hodat008/Amplifier-circuit/Actual results.png

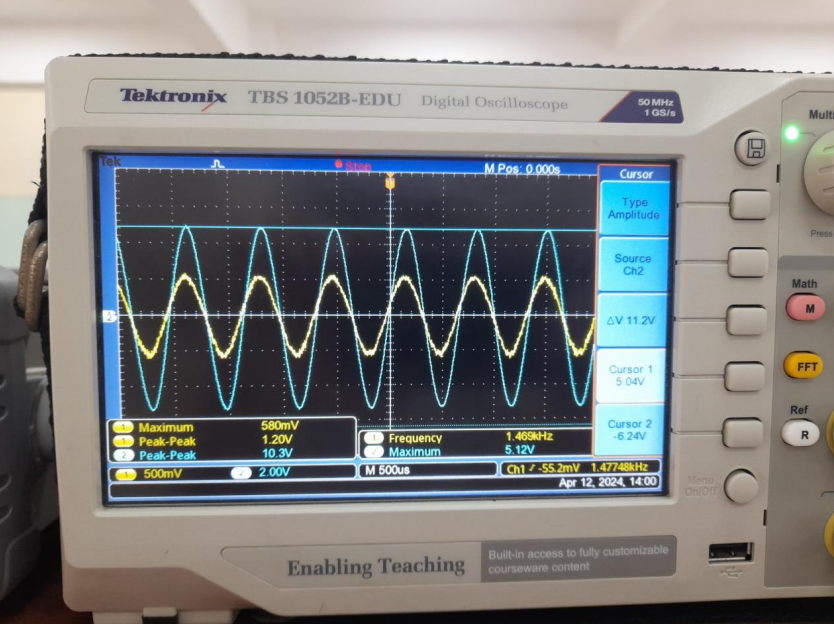
Actual results.png
