hodat008/Amplifier-circuit/README.md

# Amplifier-circuit
Design, construct and simulate amplifier circuit, meeting the following requirements:
- Input impedance: > 100K
- Output impedance: < 1K
- Input source impedance 1K, max amplitude 1Vpp
- Voltage gain: 10
- Bandwidth: 15Hz - 15KHz
