hodat008/Amplifier-circuit/Full report.pdf

I. CƠ SỞ LÝ THUYẾT

### 1.1. Cấu tạo của BJT

Transistor lưỡng cực (hay BJT - Bipolar Junction Transistor) là linh kiện bán dẫn

có cấu tạo cơ bản dựa trên 2 chuyển tiếp P-N. Linh kiện 3 điện cực này được sử dụng

như một phần tử khuếch đại hoặc như một khóa điện tử. BJT là khối đơn vị cơ bản xây

dựng nên cấu trúc mạch ở máy tính điện tử và tất cả các thiết bị điện tử hiện đại khác.

Transistor là một linh kiện bán dẫn 3 lớp, bao gồm 2 lớp bán dẫn loại N và một

lớp bán dẫn loại P (gọi là Transistor NPN) hoặc gồm 2 lớp bán dẫn loại P và một lớp

bán dẫn loại N (gọi là Transistor PNP).

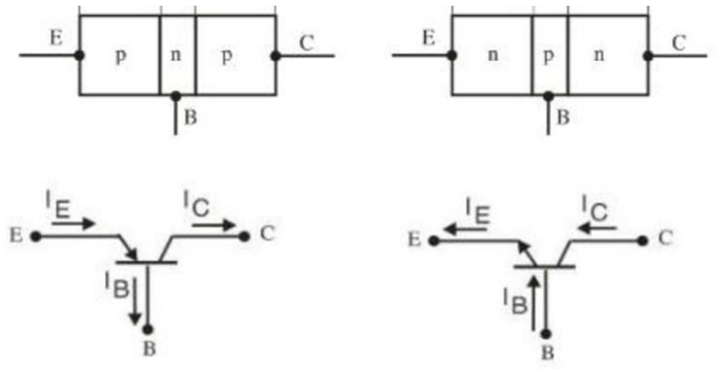
[picture p2: figure]

Cấu trúc và kí hiệu transistor PNP và NPN

Các cực được kí hiệu bằng các kí tự E (Emitter – cực phát), C (Collector – cực

thu) và B (Base – cực nền).

### 1.2. Nguyên lý hoạt động của BJT

Nguyên lý hoạt động của BJT (Bipolar Junction Transistor) dựa trên việc điều

khiển dòng điện qua các lớp bán dẫn của transistor bằng một dòng dẫn điện nhỏ hơn.

BJT là loại transistor ba khối, gồm ba lớp bán dẫn là base, emitter và collector. Trong

BJT, dòng điện chạy từ emitter tới collector và được điều khiển bởi một dòng dẫn điện

điều khiển vào base.

Ở transistor NPN, khi dòng điện dương được đưa vào base, nó sẽ kích hoạt và

tăng cường dòng điện dương chạy từ emitter tới collector. Phần lớn các hạt tải điện trong

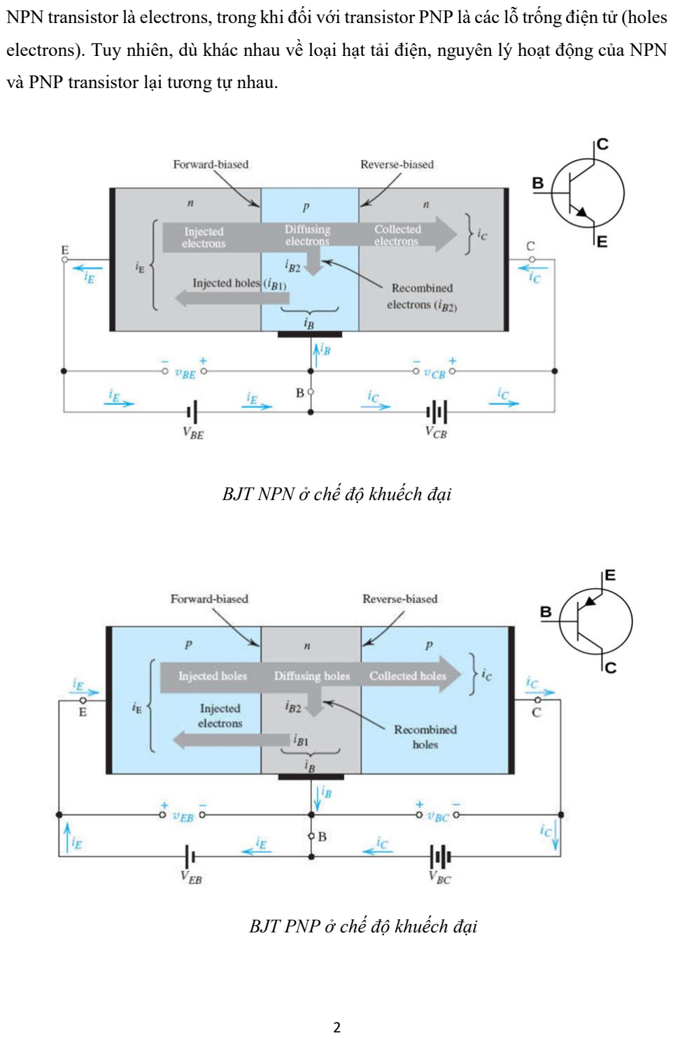
[picture p3: page 2]

NPN transistor là electrons, trong khi đối với transistor PNP là các lỗ trống điện tử (holes

electrons). Tuy nhiên, dù khác nhau về loại hạt tải điện, nguyên lý hoạt động của NPN

và PNP transistor lại tương tự nhau.

BJT NPN ở chế độ khuếch đại

BJT PNP ở chế độ khuếch đại

Trong BJT, số lượng điện tử cơ bản chịu trách nhiệm chỉ chiếm một phần nhỏ

trong tổng số dòng điện chạy qua (đa số), phần lớn dòng điện được tạo ra bởi các điện

tử không cơ bản (thiểu số). Khi một dòng dẫn điện vào base của transistor, điện trường

được tạo ra giữa hai điốt, base và emitter (hoặc collector), và điện trường này sẽ điều

khiển dòng điện chạy giữa hai diode. Do đó, BJT có thể được sử dụng để tạo ra các kết

nối ampli, chuyển đổi tín hiệu, và như một công tắc trong các mạch điện tử.

Transistor NPN là một loại transistor gồm ba lớp bán dẫn, bao gồm hai lớp N

(âm) được phân cách bởi một lớp P (dương). Chế độ hoạt động của transistor NPN bao

gồm ba trạng thái chính: cắt, bão hòa và dẫn.

Trạng thái cắt: không có dòng điện chạy qua transistor vì hai điện cực của nó

không được kết nối với nhau. Trong trạng thái này, transistor hoạt động như một vật cản

cho dòng điện.

Trạng thái bão hòa: một điện áp được áp dụng giữa đầu vào (điện cực cực âm)

và đầu ra (điện cực cực dương) của transistor, tạo ra một dòng điện cơ bản trong

transistor. Trong trạng thái này, transistor hoạt động như một bộ khuếch đại dòng.

Trạng thái dẫn: một điện áp đủ lớn được áp dụng giữa đầu vào và đầu ra của

transistor, tạo ra một dòng điện lớn trong transistor. Trong trạng thái này, transistor hoạt động như một công tắc hoặc bộ khuếch đại dòng lớn.

Trong một mạch điện, transistor NPN thường được sử dụng để khuếch đại hoặc

chuyển đổi tín hiệu điện. Chế độ hoạt động của transistor NPN là rất quan trọng trong

việc thiết kế các mạch điện tử.

### 1.3. Đặc tính của BJT

Khuếch đại dòng: BJT có thể được sử dụng để khuếch đại dòng, tức là đầu ra

lớn hơn đầu vào. Điều này là do điện áp và dòng điện được kiểm soát bởi dòng cơ bản

được điều khiển bởi dòng điều khiển.

Điều khiển dòng bằng điện áp: BJT có thể được điều khiển bằng một điện áp

nhỏ tại cổng điều khiển, dẫn đến sự điều khiển dòng điện lớn hơn tại đầu ra.

Tính chất tương tự: BJT có thể được sử dụng để kết nối hai mạch điện có điện

áp khác nhau với nhau, trong đó một mạch làm nguồn cấp điện và một mạch là đầu ra.

Điều này là do BJT có tính chất tương tự giống như tranzitor FET (Field Effect

Transistor).

Độ ổn định nhiệt độ tốt: BJT có thể giữ độ ổn định tốt ở nhiệt độ cao, điều này

giúp BJT có thể được sử dụng trong các mạch điện tử yêu cầu ổn định nhiệt độ.

### 1.4. Ứng dụng của BJT

Có 2 loại ứng dụng của BJT là: công tắc và khuếch đại

- BJT làm công tắc:

Đối với các ứng dụng làm công tắc, transistor được phân cực để hoạt động trong

vùng bão hòa hoặc vùng cắt (cutoff). Transistor trong vùng cắt sẽ hoạt động như một

công tắc mở trong khi ở trạng thái bão hòa sẽ hoạt động như một công tắc đóng.

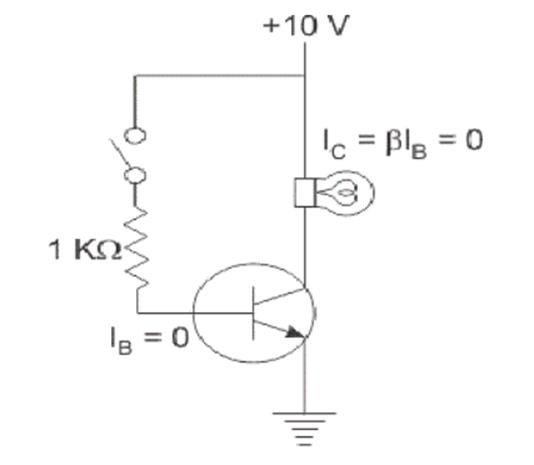
[picture p4: figure]

Công tắc mở

Trong vùng cắt (cả hai điểm nối đều bị phân cực ngược) điện áp qua điểm nối CE

rất cao. Điện áp đầu vào bằng 0 nên cả dòng điện cực gốc và dòng điện cực góp đều

bằng 0, do đó điện trở được cung cấp bởi BJT rất cao (lý tưởng là vô hạn).

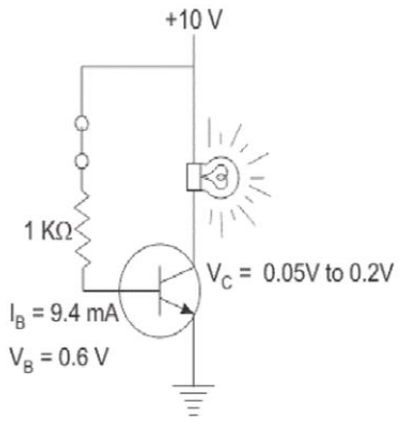
[picture p5: figure]

Công tắc đóng

Ở trạng thái bão hòa (cả hai điểm nối đều được phân cực thuận) một điện áp đầu

vào cao được được đặt vào cực gốc. Giá trị của điện trở cực gốc được điều chỉnh sao

cho dòng điện cực gốc lớn chạy qua. Có một điện áp rơi nhỏ qua đường giao nhau của

cực góp cực phát từ 0,05 đến 0,2 V và dòng điện cực góp rất lớn. Một sự sụt giảm điện

áp rất nhỏ diễn ra trên BJT và tương đương với một công tắc đóng.

- BJT làm bộ khuếch đại:

Hình dưới là một bộ khuếch đại CE một tầng. C1 và C3 là các tụ điện ghép nối

(coupling), chúng được sử dụng để chặn thành phần DC và chỉ cho phần xoay chiều đi

qua. Chúng cũng đảm bảo các điều kiện phân cực DC của BJT không thay đổi ngay cả

khi đầu vào được đặt. C2 là tụ điện bypass làm tăng độ lợi điện áp và bỏ qua điện trở R4

cho tín hiệu AC.

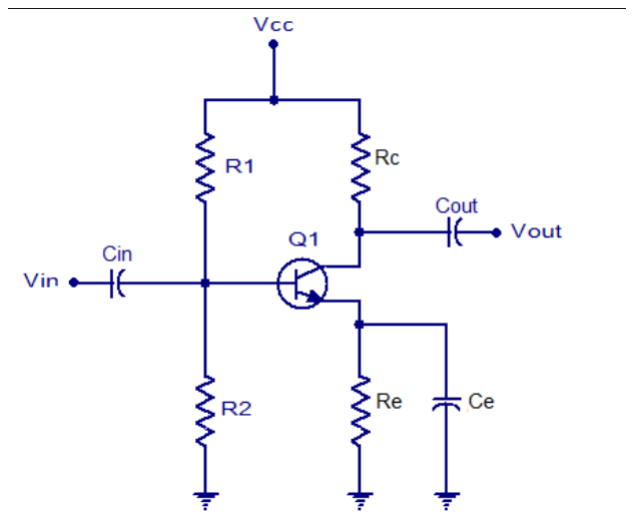
[picture p6: figure]

BJT được phân cực trong vùng hoạt động bằng cách sử dụng các thành phần phân

cực cần thiết. Điểm Q được tạo ra ổn định trong vùng hoạt động của transistor. Khi đầu

vào được đặt như hình dưới đây, dòng điện cực gốc bắt đầu thay đổi lên và xuống, do

đó dòng điện cực góp cũng thay đổi khi IC = β × IB. Do đó điện áp trên R3 thay đổi khi

dòng điện cực góp đi qua nó. Điện áp trên R3 là điện áp được khuếch đại và cách nhau

180o

so với tín hiệu đầu vào. Do đó điện áp trên R3 được ghép nối với tải và quá trình

khuếch đại diễn ra. Nếu điểm Q được duy trì ở tâm tải thì sẽ có rất ít hoặc không xảy ra

hiện tượng méo dạng sóng. Điện áp cũng như độ lợi dòng điện của bộ khuếch đại CE

cao (độ lợi là hệ số mà điện áp của dòng điện tăng từ đầu vào đến đầu ra). Nó thường

được sử dụng trong radio và làm bộ khuếch đại điện áp tần số thấp.

### 1.5. Các mạch khuếch đại cơ bản thường gặp

Mạch khuếch đại là mạch điện tử trong đó với một sự biến đổi nhỏ của đại lượng

điện ở đầu vào sẽ gây ra sự biến đổi lớn của đại lượng điện ở đầu ra. Các phần tử cơ bản

của mạch điện là BJT hay FET,... Dùng BJT để làm mạch khuếch đại, khi đó ta cần thiết

kế sao cho BJT hoạt động ở chế độ active mode (tức là điểm làm việc tĩnh nằm ở vùng

active).

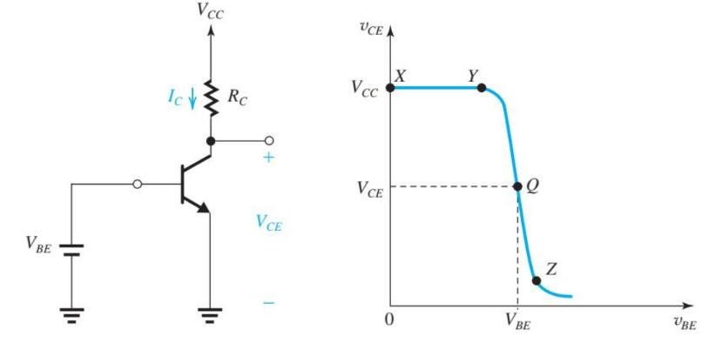
[picture p7: figure]

* Các mạch khuếch đại cơ bản:

a. Mạch khuếch đại ghép E chung (Common Emitter - CE)

Mạch khi xét ở chế độ AC có dạng:

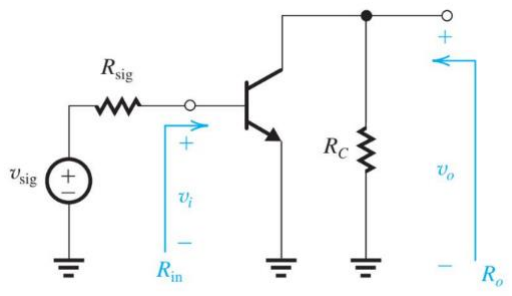
[picture p8: figure]

Mạch tương đương tín hiệu nhỏ:

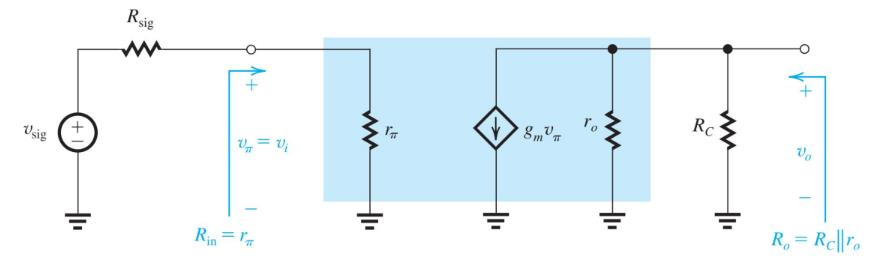
[picture p9: figure]

Rin = rπ; Ro = RC//ro ≈ RC

AV =

vo
vi

= −gm(RC//ro) ≈ −gmRC; GV =

vo

vsig

= −

rπ

rπ+Rsig

gm(RC//ro)

- Đặc điểm thường có của mạch:

+ Tổng trở vào (Ri) khoảng vài KΩ

+ Tổng trở ra (Ro) từ vài chục KΩ đến vài trăm KΩ

+ Hệ số khuếch đại dòng điện (Ai): lớn từ vài chục đến hàng trăm lần

+ Hệ số khuếch đại điện áp (AV): lớn cỡ hàng trăm lần

+ Điện áp ra (Vo) ngược pha so với điện áp vào (Vi)

+ Dải thông của mạch hẹp b. Mạch khuếch đại ghép B chung (Common Base - CB)

Mạch khi xét ở chế độ AC có dạng:

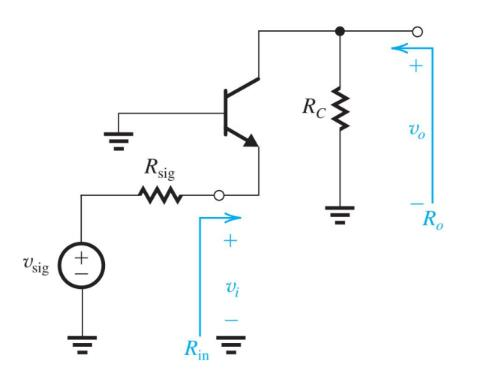
[picture p10: figure]

Mạch tương đương tín hiệu nhỏ:

Rin = re

; Ro ≈ RC

AV =

vo
vi

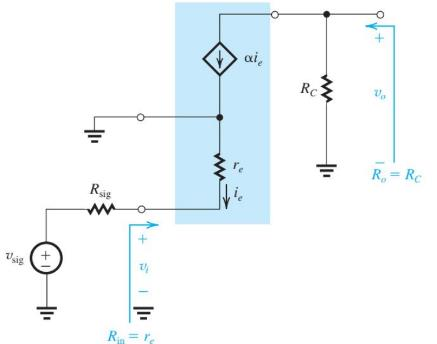
[picture p11: figure]

= gmRC; GV =

vo

vsig

=

re

re+Rsig

gmRC

- Đặc điểm thường có của mạch:

+ Tổng trở vào (Ri) khoảng vài chục Ω

+ Tổng trở ra (Ro) vài trăm KΩ

+ Hệ số khuếch đại dòng điện (Ai): nhỏ, xấp xỉ 1

+ Hệ số khuếch đại điện áp (AV): lớn cỡ hàng trăm lần

+ Điện áp ra (Vo) cùng pha so với điện áp vào (Vi)

+ Dải thông của mạch rộng c. Mạch khuếch đại ghép C chung (Common Colector – CC)

Mạch khi xét ở chế độ AC có dạng:

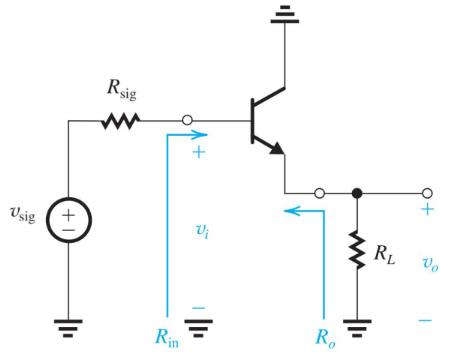
[picture p12: figure]

Mạch tương đương tín hiệu nhỏ (xem ro rất lớn -> bỏ qua):

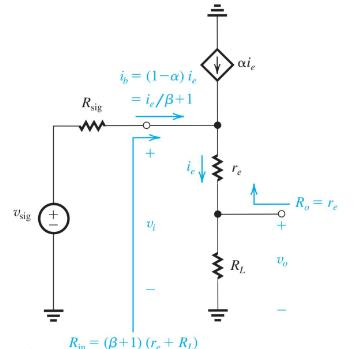
[picture p13: figure]

Rin = (β + 1)(re + RL

); Ro = re

AV =

vo
vi

=

RL
re+RL
- Đặc điểm thường có của mạch:

+ Tổng trở vào (Ri) khoảng vài KΩ

+ Tổng trở ra (Ro) khoảng vài chục Ω

+ Hệ số khuếch đại dòng điện (Ai): lớn, từ vài chục đến hàng trăm lần

+ Hệ số khuếch đại điện áp (AV): nhỏ, xấp xỉ 1

+ Điện áp ra (Vo) cùng pha so với điện áp vào (Vi)

+ Dải thông của mạch trung bình

II. | CƠ SỞ TÍNH TOÁN, BIỆN LUẬN CÁC GIÁ TRỊ, THÔNG SỐ CỦA
| MẠCH
| Để đáp ứng điện trở vào cao ( Ri >100k Ω), điện trở ngõ ra thấp (Rout ≤ 1kΩ) với
độ lợi AV = 10; và để đảm bảo tín hiệu ngõ ra cùng pha với tín hiệu ngõ vào (đảm bảo giữ được các tính chất cơ bản của tính hiệu đầu vào) => Ta sử dụng mạch khuếch đại Cascade CE-CE với các thông số trở của hai mạch khác nhau để đảm bảo các yêu cầu đặt ra của đề bài.
| Với yêu cầu đề là Rs = 1kΩ nhóm chọn giá trị R=1kΩ để thỏa mãn đề bài. Chọn
giá trị ngõ vào là 1V (Vp-p) để thuận tiện cho ngõ vào lớn nhất mà mạch có thể đáp ứng.
| Và dưới đây là dạng mạch mà nhóm em đã sử dụng để tiến hành thiết kế:

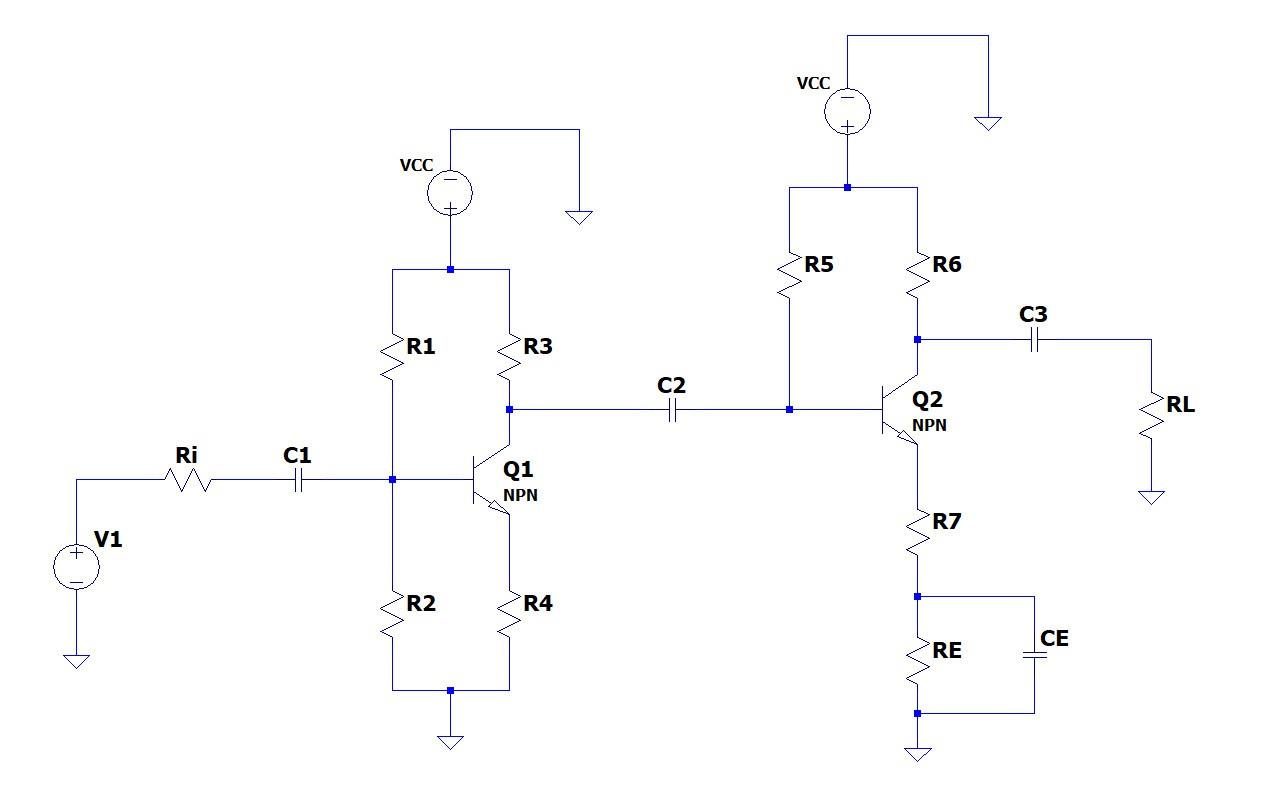
[picture p14: figure]

### 2.1. Chọn BJT để thiết kế mạch

Vì tính dễ hoạt động, dễ tìm và chi phí rẻ nên nhóm lựa chọn BJT 2N222 để thiết

kế mạch.

Datasheet:

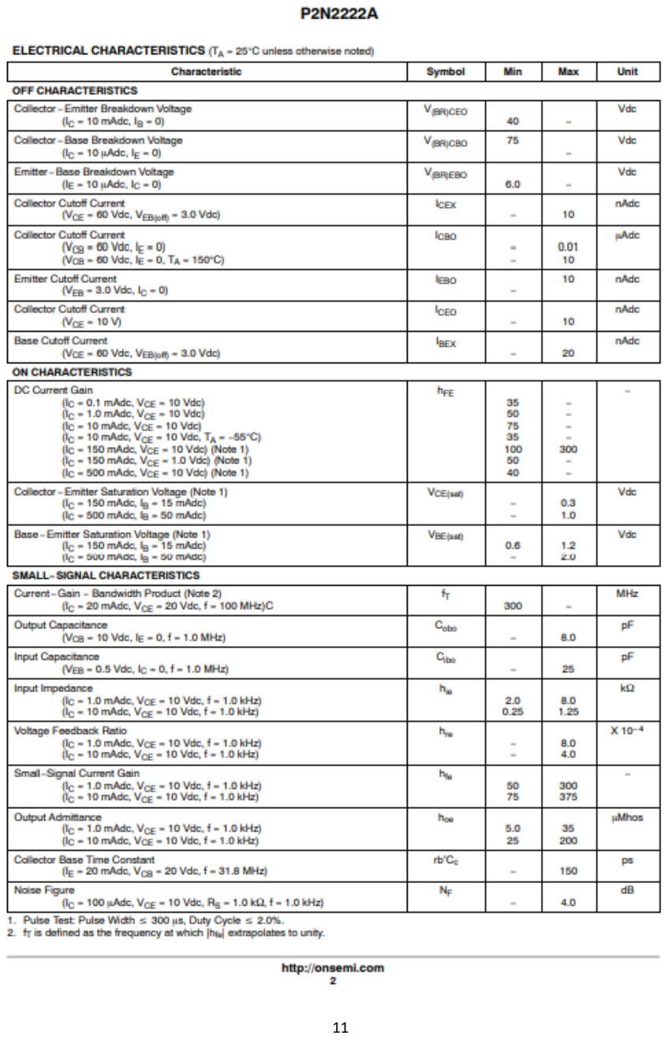
[picture p15: page 11]

### 2.2. Thiết kế tầng đệm:

Sau khi đã chọn BJT, chúng em sẽ tìm các thông số của điện trở cho tầng đệm:

Chọn điểm hoạt động của BJT 2N2222 thứ 1: Q (ICQ1, VCEQ1) = (2mA, 5V), β1 = 200

Chọn VCC = 18V, chọn VCEQ1 = 3.3kΩ, R2=330kΩ

Ta có:

Mặt khác:

1 | 1 3 | 4 .( | ) V | I | R | R | V CC | C | CE = | + | + 3

3

18 2.10 .( | 3,3 ) 5 R | k -
= | + | +
- R3 = 3.2k => Chọn R3 = 3.3kΩ

Và

1

1

1 2
4
1 | 1 | 2
3 | 3 | 3
1 | 3 | 3
3 | 3
1 | 1
. | . | | 0,7
330.10 | 2.10 | .330.10 18. | . | 2.10 .3,3.10 | 0,7
330.10 | 200 | 330.10

C
th | C
I | RR V | I R
R | R

R
R | R

β

= | + | +
+
Û | = | + | +
+ | +
| → R1 = 333kΩ. Chọn R1 = 330kΩ

Sau khi có các giá trị điện trở của phần mạch CE đầu tiên nhóm em tiến hành vẽ lại mạch trên mô phỏng proteus và cung cấp nguồn 18V DC để tính và kiểm chứng lại

giá trị của β1 và tính toán giá trị của

1

Rπ .

Mạch mô phỏng của đoạn mạch này ở chế độ DC là:

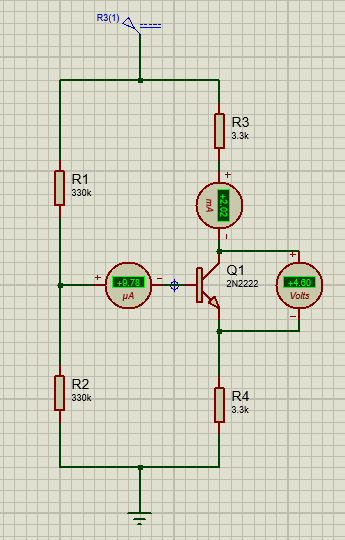
[picture p16: figure]

Từ các thông số của đồng hồ DC, nhóm em tính được:

β1 =

ICQ1

IB1

=

2mA
10μA

= 200

Từ đó tìm được giá trị:

rπ1 = β1 ×

VT

ICQ1

= 200 ×

25mV
2mA

= 2.5kΩ

Tiến hành tính toán lại giá trị Zin ta có giá trị:

Zin =

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
rπ1 + (β1 + 1) × R4

=

1
1
330k

+

1
330k

+

1
2.5k + (200 + 1) × 3.3k

= 132.23kΩ

- Thỏa mãn được yêu cầu của đề bài về phần Zin > 100kΩ

### 2.3. Tầng khuếch đại

Đối với đoạn mạch CE thứ 2: Đoạn mạch chính để đáp ứng độ lợi của toàn mạch.

Chọn điểm hoạt động của BJT 2N2222 thứ 2: Q (ICQ2,VCEQ2) = (9mA, 6V), β2 =

200

Với sơ đồ tương đương như hình dưới và đáp ứng yêu cầu Zout < 1kΩ, nhóm em tiến hành chọn giá trị cho RC2 = 990Ω để vừa đảm bảo giá trị ngõ ra thỏa mãn yêu cầu đề bài và độ lợi của toàn mạch đạt giá trị lớn khả quan.

Chọn VCC=18V, chọn R6 = 990Ω

Ta có:

2 | 6 | 7 | 2 .( | ) V | I | R | R | V CC | CQ | CEQ = | + | + 3

7

18 9.10 .(990 ) 6 R

= | + | +
- R7 = 350Ω
- Để đảm bảo độ lợi của toàn mạch là 10 thì giá trị của điện trở RE3 <

RC2
10

= 99Ω

Nhóm em lựa chọn giá trị của trở R7 = 66Ω; RE = 330Ω.

Và

2

2

5 | 7
2
. | . | 0,7 CQ
CC | | CQ

I
V | R | I | R
β
= | + | +

18 =

9 × 10⁻³
200

. R5 + 9 × 10⁻³
. 350 + 0.7

=>R5 = 305kΩ . Chọn R5 = 330kΩ

Sau khi có các giá trị điện trở của phần mạch CE thứ hai nhóm em tiến hành vẽ lại mạch trên mô phỏng proteus và cung cấp nguồn 18VDC để tính và kiểm chứng lại giá trị của β2 và tính toán giá trị của rπ2

Mạch mô phỏng của đoạn mạch này ở chế độ DC là:

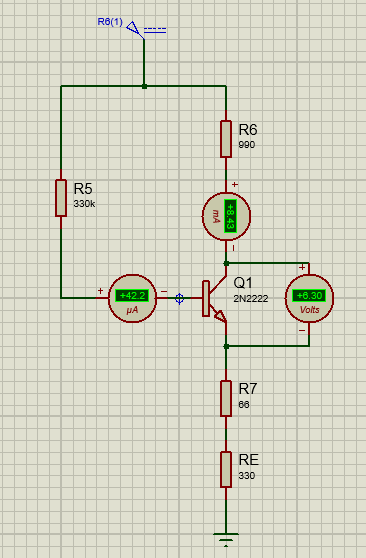
[picture p17: figure]

Từ các thông số của đồng hồ DC, nhóm em tính được:

β2 =

ICQ2
IB

=

8.43mA
42.2μA

= 200

Từ đó tìm được giá trị:

rπ2 = β2 ×

VT

ICQ2

= 200 ×

25mV
8.43mA

= 593Ω

- Khảo sát AC: Tín hiệu dãy giữa:

Sơ đồ tương đương AC:

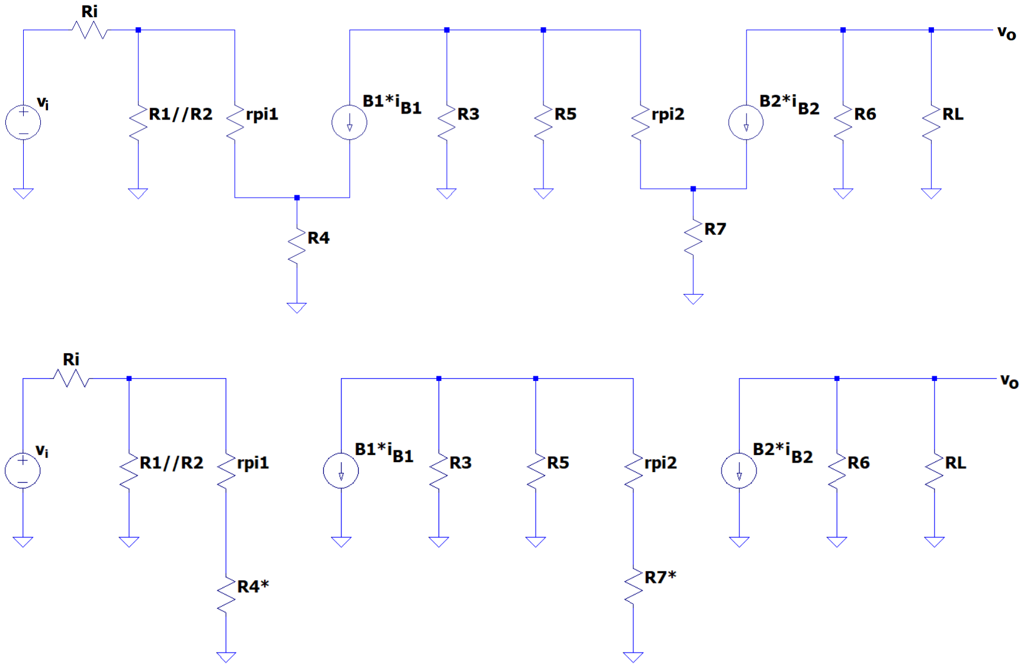
[picture p18: figure]

Ta có:

rπ1 = 2,5kΩ; R4 = (β1 + 1). R4 = 201.3,3kΩ = 663,3kΩ; R12 = R1||R2 = 165kΩ;
rπ2 = 556Ω; R7 = (β2 + 1). R7 = 201.66Ω = 13,3kΩ; R35 = R3||R5 = 3,3kΩ

### 2.4. Tín hiệu dãy giữa:

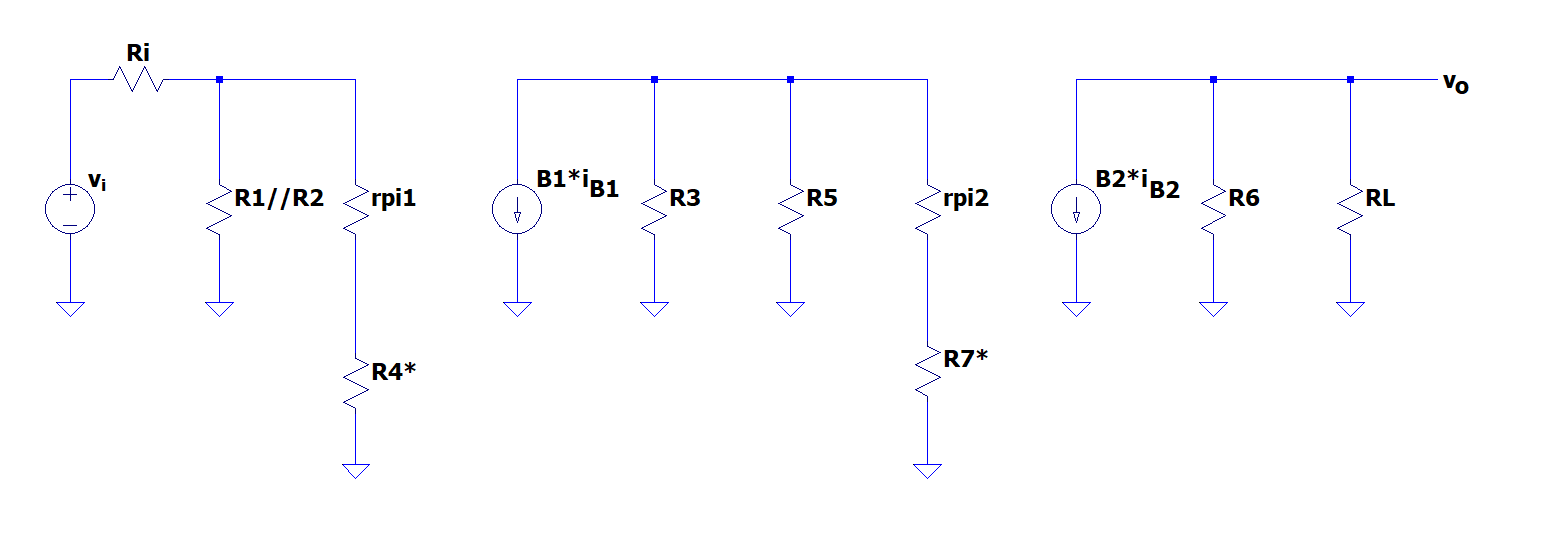
[picture p19: figure]

Ta có:

2 | 2 | 1 | 1
2 | 2 | 1 | 1
2 | 1
2 | 1
o | o | b | b | b | b
v
i | b | b | b | b | i
v | v | i | i | i i
A
v | i | i | i | i | v
| | β | | β
β | β
= | =

Trong đó:

Vo
β2ib2

= −(RL

∥ R6)

β2ib2

ib2

= β2

ib2
β1ib1

= −

(R3 ∥ R5)
rπ2 + R7

(β2 + 1) + (R3 ∥ R5)

β1ib1

ib1

= β1

ib1
Vi

= Ri

1
(R1 ∥ R2) + rπ1 + R4

(β1 + 1)
(R1 ∥ R2)

+ rπ1 + R4

(β1 + 1)

Suy ra:

Av = −RL

∥ R6 × β2 × (−

R3 ∥ R5
rπ2 + R7

∗ + R35

) × β1 ×

Ri
R12 + rπ1 + R4

∗
R12

+ rπ1 + R4

∗

Av = −(10k ∥ 990k) × 200 ×

3.3k
593 + 13.3k + 3.3k

× 200

×

1k
165k + 2.5k + 663.3k
165k

+ 2.5k + 663.3k

Mà Av= 10

Nên (RL
∥ R6

) = 0.9kΩ

Suy ra: RL = 9.9kΩ

Vậy ta chọn điện trở RL

trong thực tế có giá trị bằng 10 kΩ

### 2.5. Đáp ứng dải băng thông của mạch:

Sau khi đáp ứng độ lợi của mạch, nhóm em tiến hành mô phỏng trên phần mềm LT SPICE để xác định dải băng thông, tìm các thông số của các tụ để tần số cắt của mạch là 15Hz, và tần số cắt cao là 15KHz.

Với độ lợi là AV = 10 (V/V) thì ta tính được chỉ số dB là 20dB → Tần số cắt thấp và tần số cắt cao để xác định tần số là 20dB – 3dB = 17dB Sau khi tiến hành thay đổi giá trị của các tụ, nhóm em nhận thấy ở giá trị tụ được cho trong hình thì mạch đáp ứng được tần số cắt thấp và tần số cắt cao thỏa mãn được giá trị tối ưu (gần nhất so với 15KHz)

a. Tần số thấp:

Khảo sát DC: Tần số thấp:

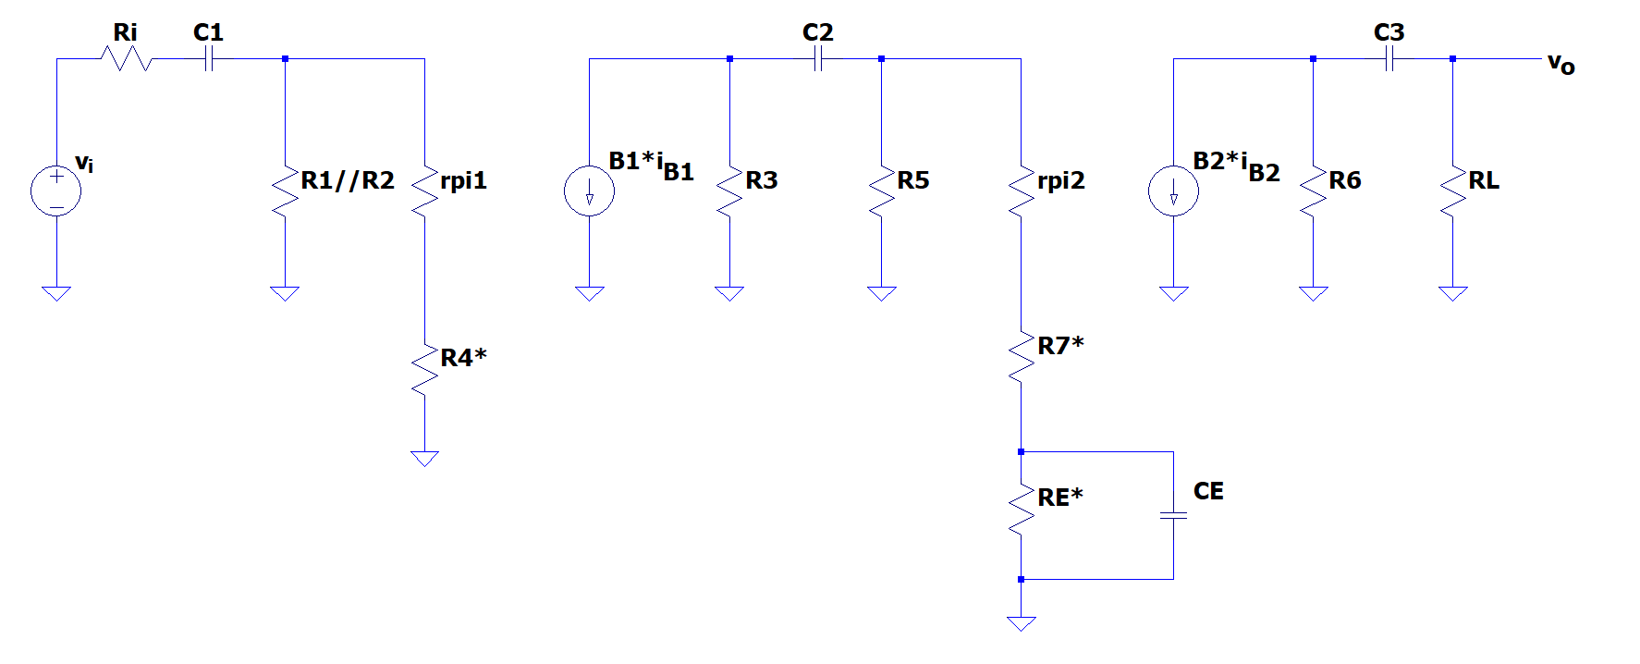
[picture p20: figure]

Tụ C1:

fL1 =

1

### 2π.[(R1 + R12)||(r

### π1 + R4)]C1

=

1

### 2π.[(1k + 165k)||(2,5k + 633,3k)]C1

=

1
837k.C1

Tụ C2:

fL2 =

1

### 2π.[(R3 + R5)||(r

### π2 + R7)]C2

=

1

### 2π.[(3,3k + 330k)||(556 + 13,3k)]C2

=

1
104,5k.C2

Tụ C3:

3
6 | 3 | 3 | 3
1 | 1 | 1
2 .( | ). | 2 .(990 10 ). | 69 . L
L

f
π | π R | R C | k C | k C
= | = | =
+ | +

Tụ CE:

fLCE =

1

### 2π.[RE||(R7 +

### rπ2 + R35

β2

)]CE

=

1
2π.[330||(66 +

556 + 3,3k
200 + 1

)CE

=

1
426.CE

Ta có

1 | 2 | 3 , | ,
C | C | C E | E | E L | L | L | L | L | L f | f f | f f | f >> | >> | >>

Nên

1
15
426. CE
L | L
E
f | f | Hz
C
= | = | ≥

Suy ra: Tụ CE ≤ 149,6µF

Chọn các tụ như sau:

- Tụ có nhiệm vụ ngăn cách hai mạch ở chế độ DC C2 và C3 mang giá trị là 100μF.
- Các tụ có nhiệm vụ ngắn mạch trở ở chế độ AC của chân E của mạch chứa BJT thứ 2 là CE mang giá trị 100μF.
- Tụ ngăn cách nguồn vào mạch C1 mang giá trị là 100μF.
b. Tần số cao

Khi BJT hoạt động ở tần số cao, xuất hiện 2 tụ ký sinh là CBE =25pF và CBC =

8pF. Ta có sơ đồ với các tụ ký sinh như sau:

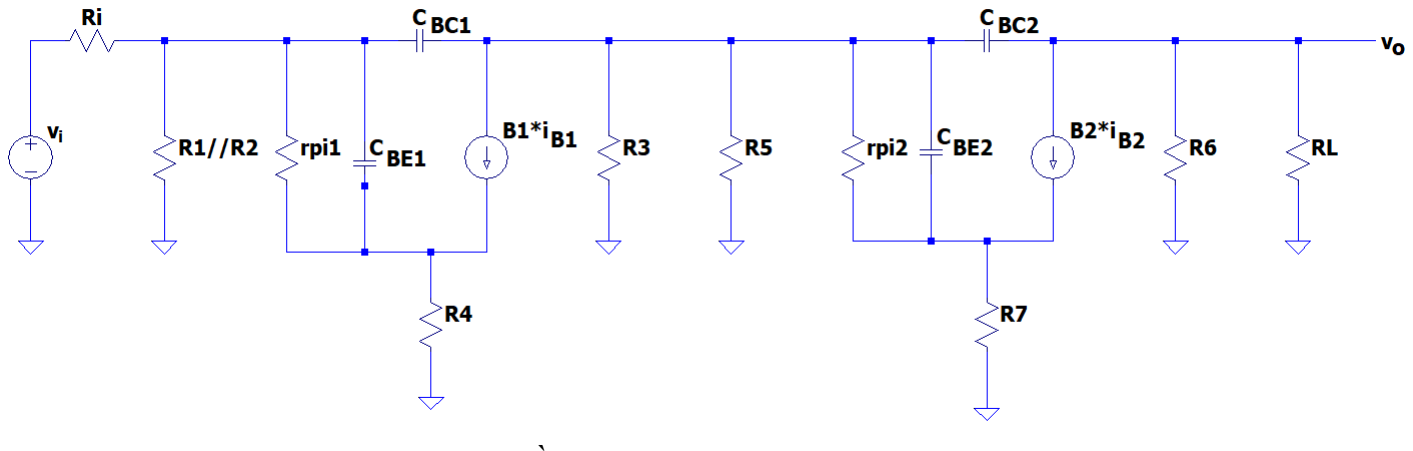
[picture p21: figure]

Xét các tụ ký sinh trên tầng đệm:

Ta có:

CEQ1 = CBC1.{1 + gm1.[R35||(rπ2 + R7

∗
)]} = 8pF.{1 + 0,08.[3,3k||(593 + 13,3k)]} = 1714pF Sơ đồ tương đương:

Tụ

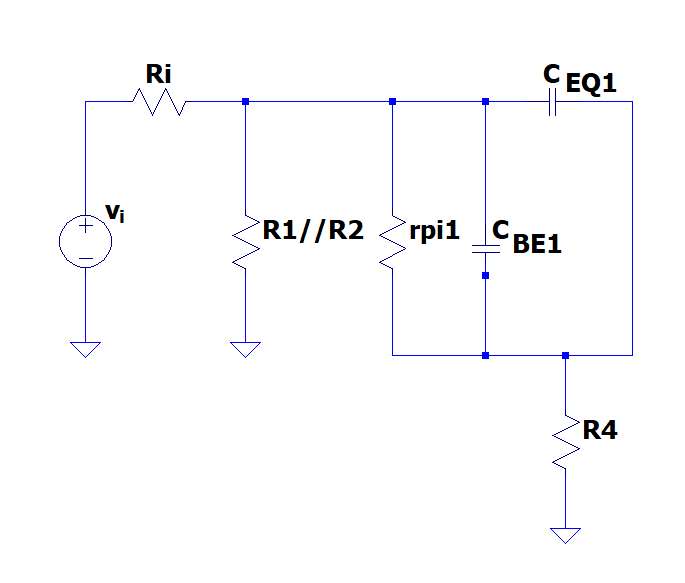
[picture p22: figure]

1 | 1 | 1 | 1714 25 1739 C | C | C | pF in | EQ | BE = | + | = | + | =

fH1 =

1

### 2π.[(R12 + rπ1)||R4]Cin1

=

1

### 2π.[165k + 2,5k)||3,3k]Cin1

= 28kHz

Xét các tụ ký sinh trên tầng khuếch đại:

Ta có:

2 | 2 | 2 | 6 .(1 | . | || | )

8 .(1 0,34.990 ||10 ) 2700

C | C | g R | R EQ | BC | m | L
p | k | pF
= | +
= | + | | | | | =

Sơ đồ tương đương:

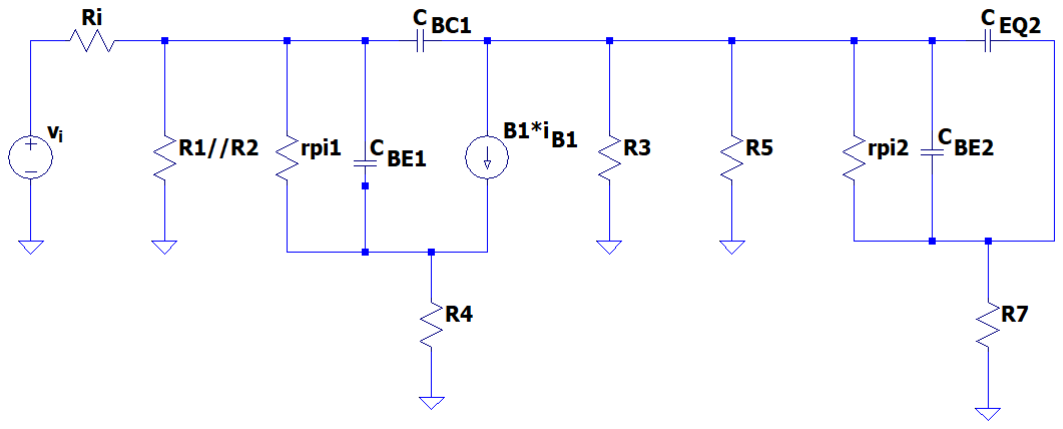
[picture p23: figure]

Tụ

2 | 2 | 2 | 2700 25 2725 C | C | C | pF in | EQ | BE = | + | + | + | =

fH2 =

1

### 2π.[R7||(rπ2 + R35)]Cin2

=

1

### 2π.[66||(593 + 3,3k)]2725p = 900kHz

Ta có: fH1 và fH2 đều lớn hơn tần số cắt cao mà đề tài yêu cầu là 15kHz. Để khắc

phục, chúng em nối thêm tụ C4 ở giữa 2 cực B và C của BJT ở tầng khuếch đại như sau:

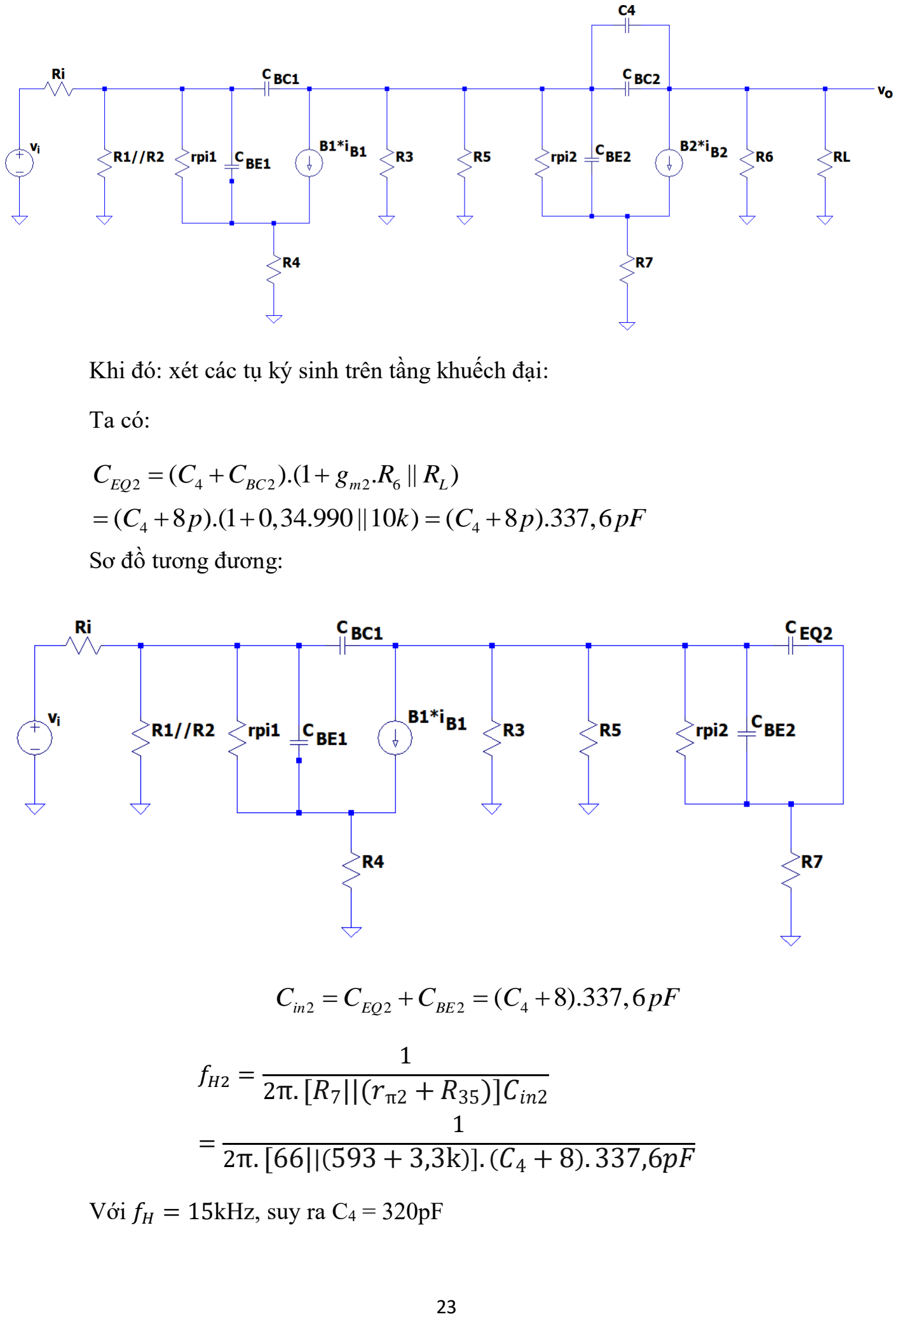
[picture p24: page 23]

Khi đó: xét các tụ ký sinh trên tầng khuếch đại:

Ta có:

2 | 4 | 2 | 2 | 6
4 | 4
( | ).(1 | . | || | )
( | 8 ).(1 0,34.990 ||10 ) ( | 8 ).337,6
C | C | C | g R | R EQ | BC | m | L
C | p | k | C | p | pF
= | + | +
= | + | + | = | +
Sơ đồ tương đương:
2 | 2 | 2 | 4 ( | 8).337,6 C | C | C | C | pF in | EQ | BE = | + | = | +

fH2 =

1

### 2π.[R7||(rπ2 + R35)]Cin2

=

1

### 2π.[66||(593 + 3,3k)]. (C4 + 8). 337,6pF

Với fH = 15kHz, suy ra C4 = 320pF

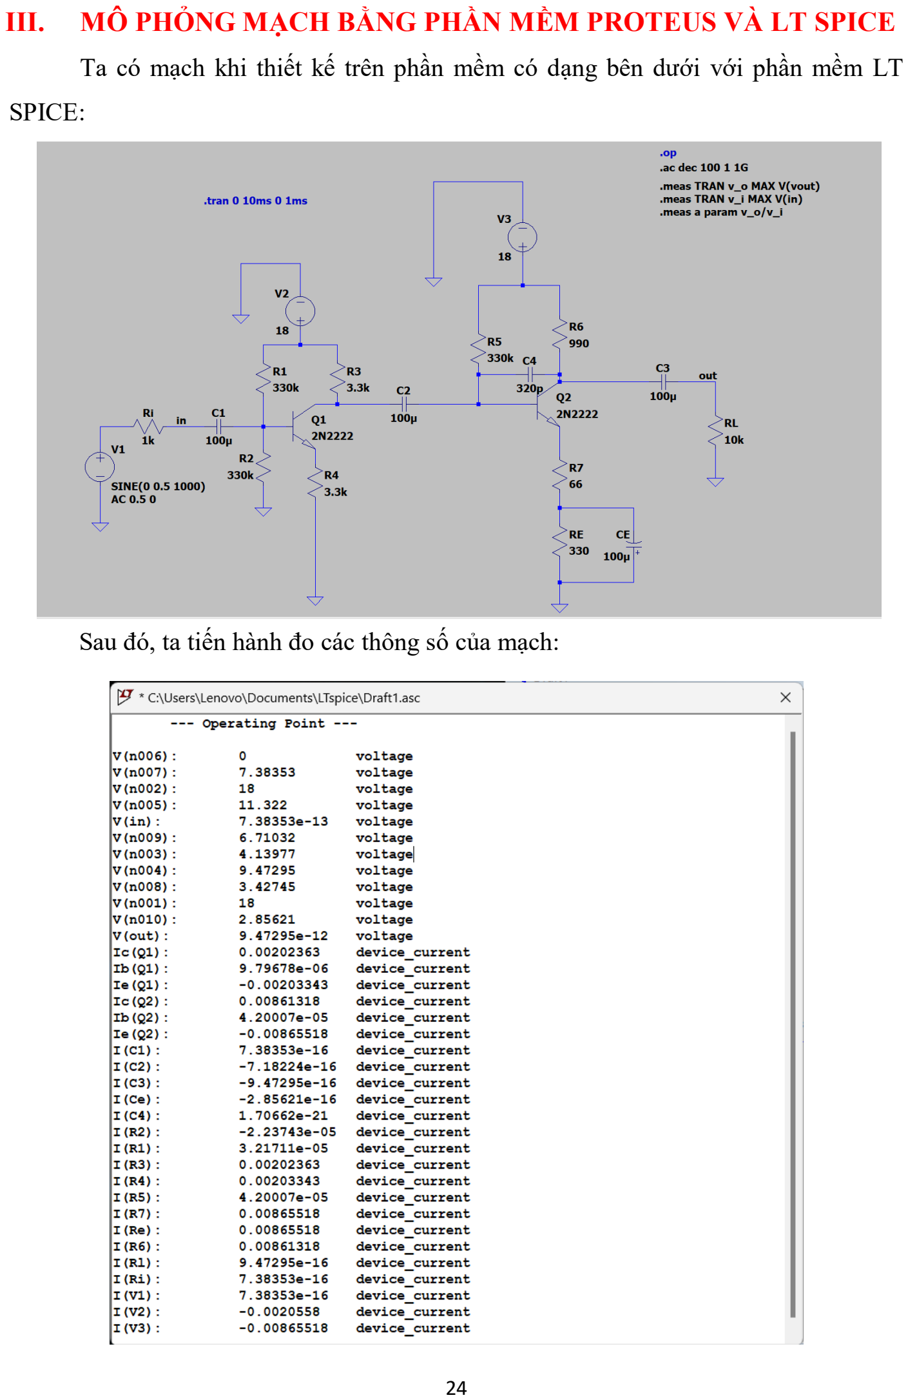
[picture p25: page 24]

III. | MÔ PHỎNG MẠCH BẰNG PHẦN MỀM PROTEUS VÀ LT SPICE
| Ta có mạch khi thiết kế trên phần mềm có dạng bên dưới với phần mềm LT

SPICE:

Sau đó, ta tiến hành đo các thông số của mạch:

### 3.1. Đo độ lợi AV:

Đối với phần mềm PROTEUS:

Mạch mô phỏng của nhóm em có dạng như hình dưới: Với nguồn DC là 18V,

nguồn vào sóng sin biên độ Vp-p = 1V

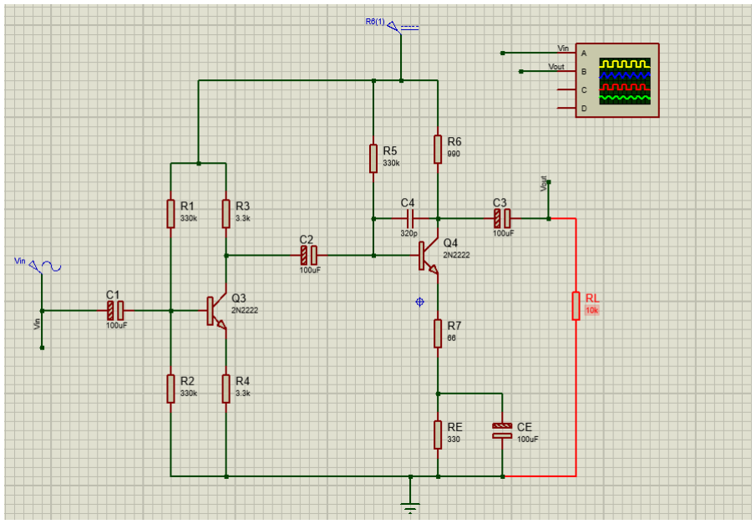
[picture p26: figure]

Trong đó nguồn vào được chọn như sau:

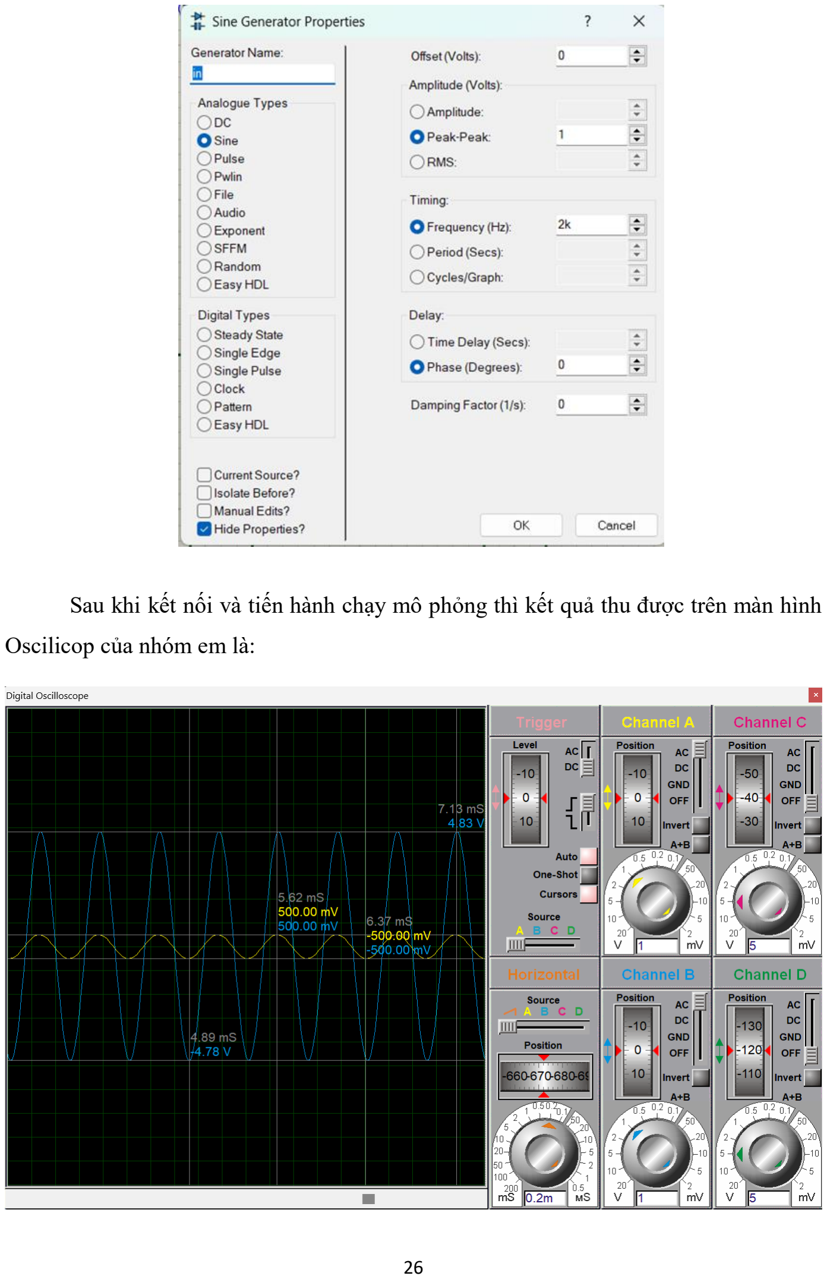
[picture p27: page 26]

Sau khi kết nối và tiến hành chạy mô phỏng thì kết quả thu được trên màn hình

Oscilicop của nhóm em là:

Kết quả trên cho thấy độ lợi của mạch trên ứng dụng mô phỏng là AV =10

Để kiểm chứng hơn về tính xác thực của mạch nhóm em cũng thử chọn nguồn vào

AUDIO với biên độ Vpp =1V đầu ra kết nối với LOA Speak như hình dưới.

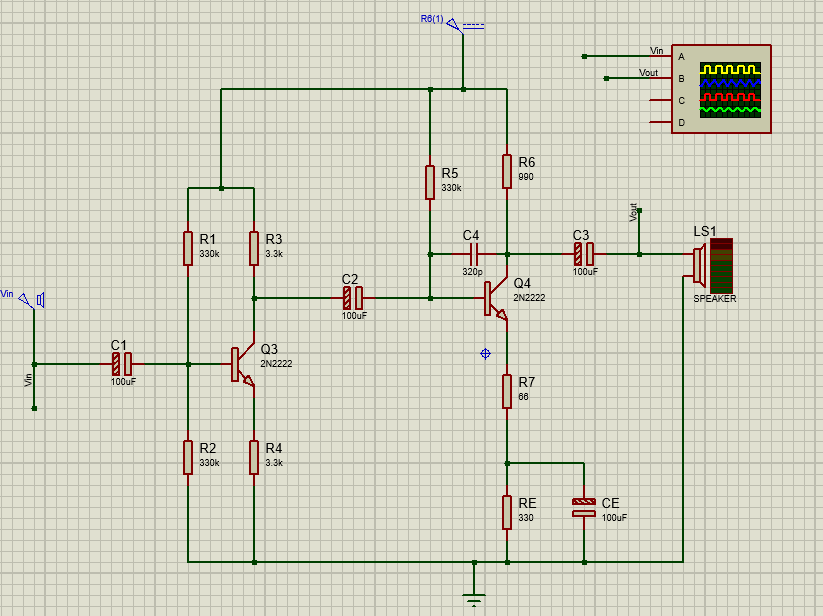
[picture p28: figure]

Với nguồn vào AUDIO được thiết lập các thông số:

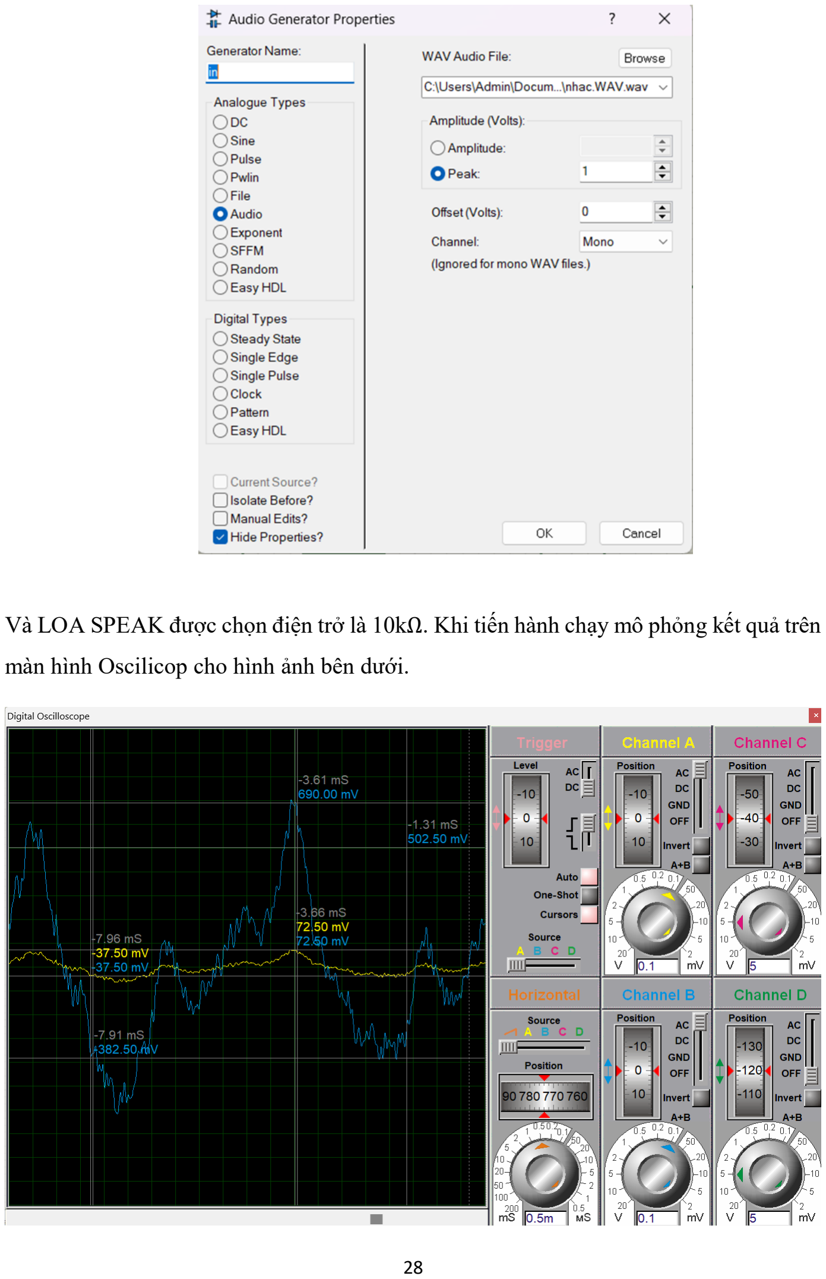
[picture p29: page 28]

Và LOA SPEAK được chọn điện trở là 10kΩ. Khi tiến hành chạy mô phỏng kết quả trên

màn hình Oscilicop cho hình ảnh bên dưới.

Với đường màu xanh (bên trên) biểu thị dạng sóng ngõ ra và đường màu vàng (bên dưới) biểu thị dạng sóng ngõ vào.

Ta nhìn thấy hai dạng sóng cùng pha nhau và sóng ngõ ra có biên độ gấp 10 lần so với sóng ngõ vào (căn chỉnh phần V/div của Channel B gấp 10 lần Channel A).

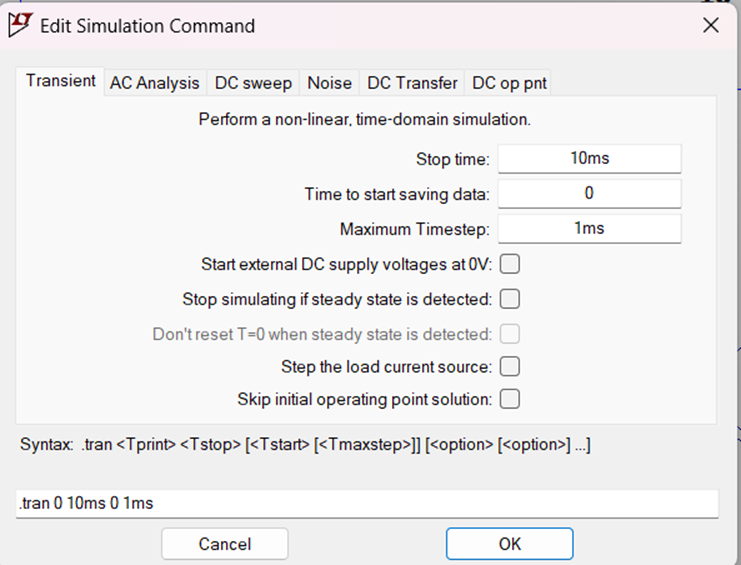
[picture p30: figure]

Cài đặt các giá trị như trong ảnh rồi tiến hành chạy (RUN).

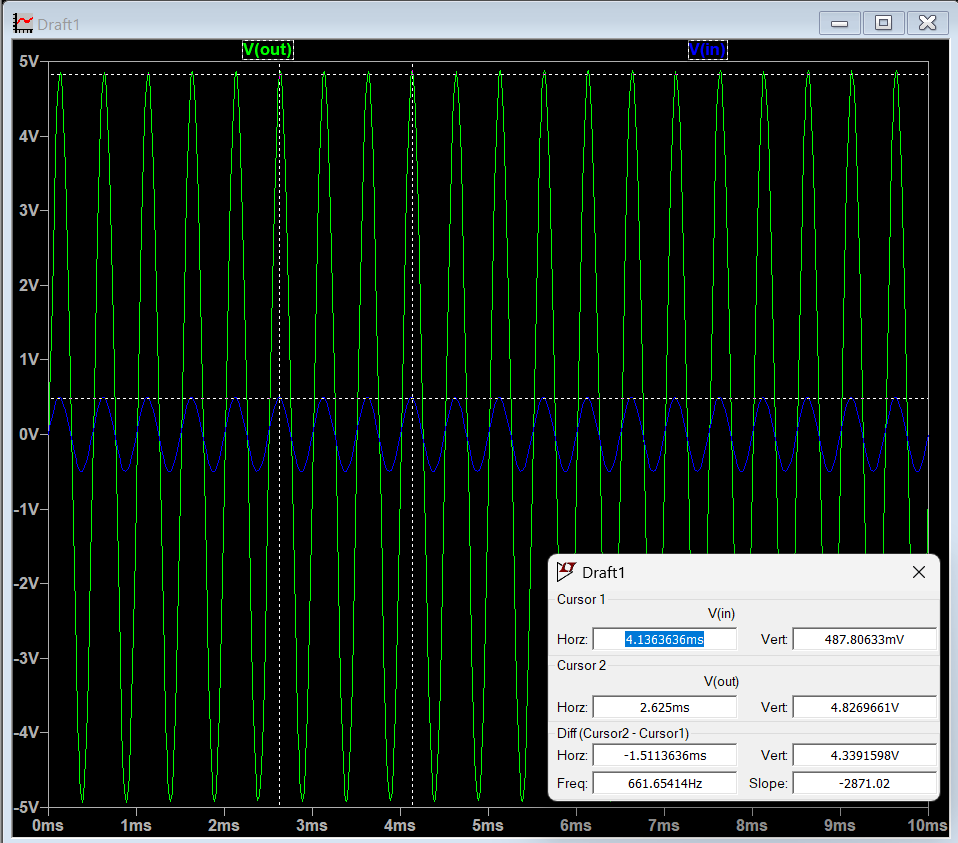
[picture p31: figure]

Ta có hình ảnh của sóng ngõ ra và vàp (màu xanh lá – ngõ ra; màu xanh dương ngõ vào).

Kết quả cho ta độ lợi của mạch là: 9.9 ≈ 10 → Đáp ứng được yêu cầu độ lợi của bài toán.

### 3.2. Đo dải băng thông:

Ta tiến hành cài đặt các thông số như trong bảng dưới để đo băng thông của mạch.

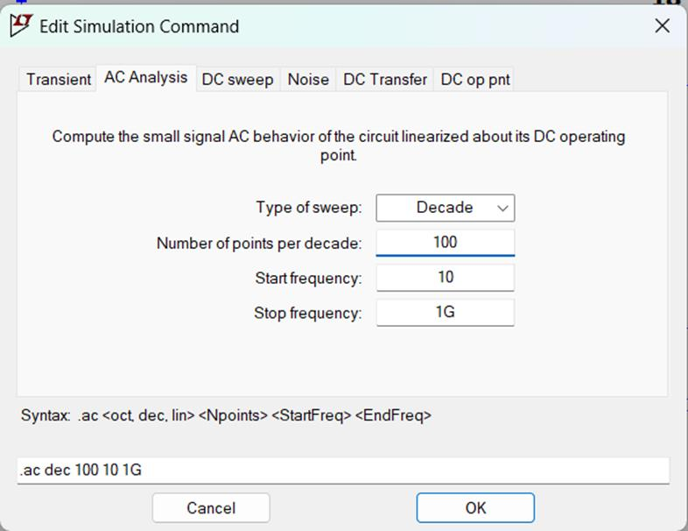
[picture p32: figure]

Và hình dưới là kết quả của băng thông của mạch khi mô phỏng trên LT SPICE

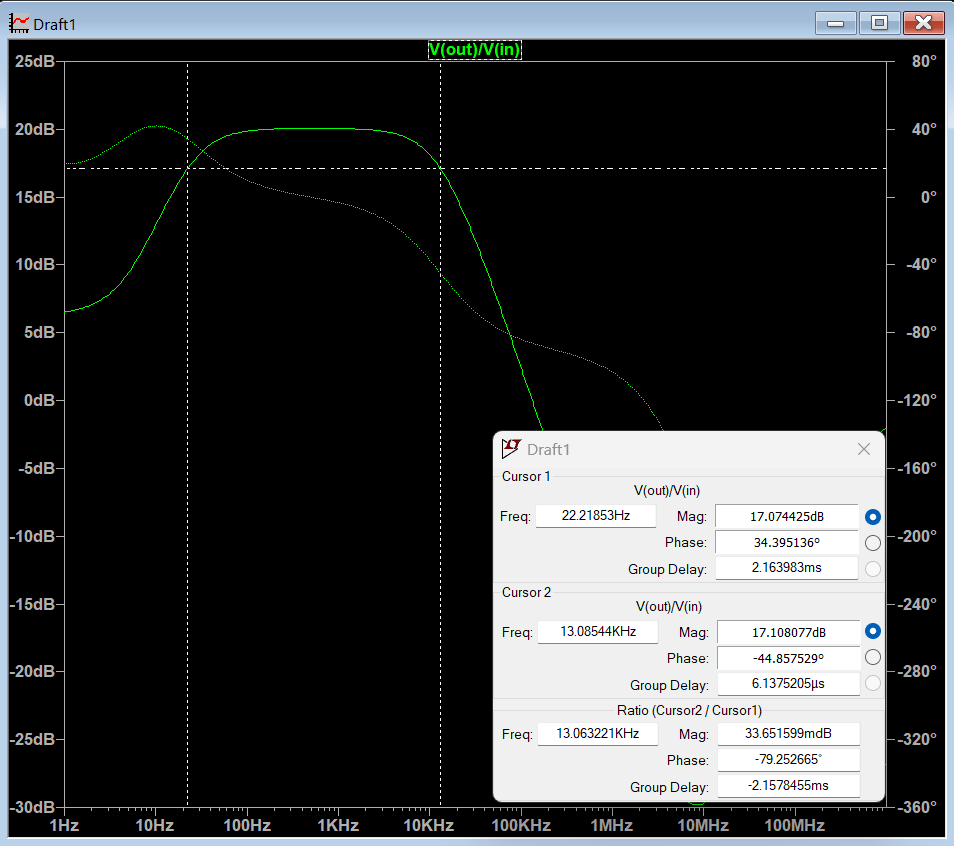
[picture p33: figure]

Đường biểu diễn sự phụ thuộc của cường độ sóng (dB) vào tần số Hz

Trong đó điểm 1 có tọa độ 17dB là điểm của tần số cắt thấp của mạch (xấp xỉ

22Hz, điểm 2 có tọa độ 17 dB là điểm của tần số cắt cao của mạch (xấp xỉ 13kHz).

### 3.3. Đo trở kháng vào Zi và trở kháng ra Zo

Trở kháng vào Zi:

Công thức xác định:

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
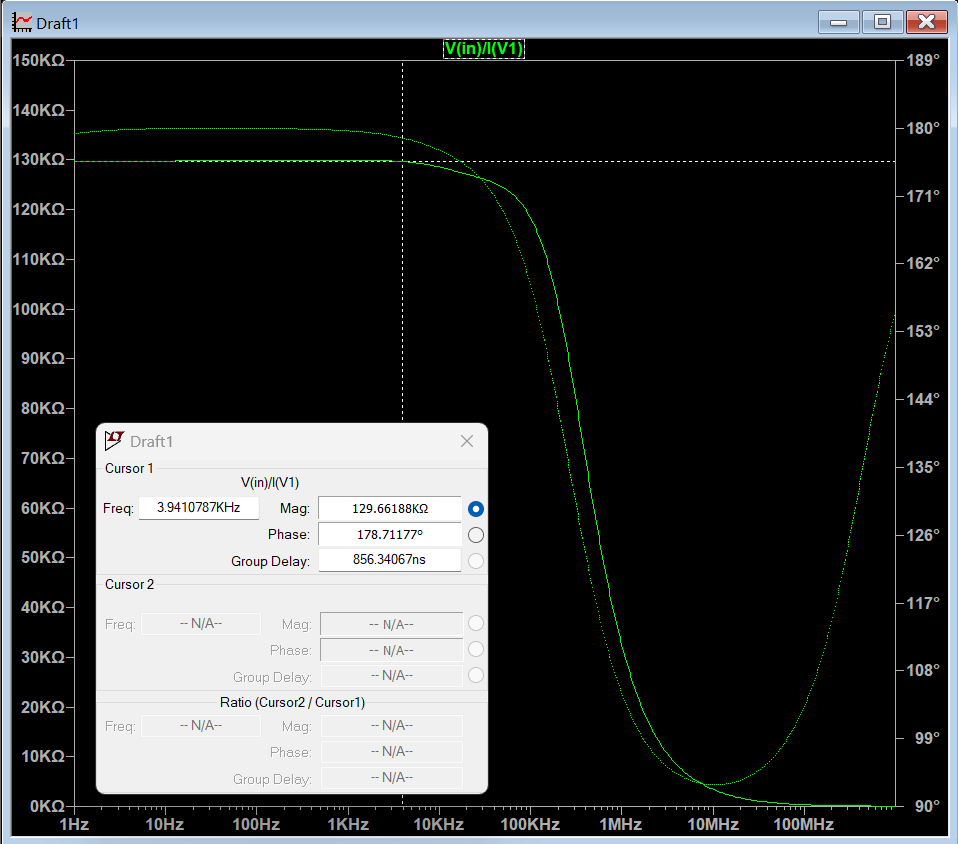
[picture p34: figure]

Đường biểu diễn sự phụ thuộc của trở kháng vào (Ω) vào tần số Hz

Trở kháng ra Zo:

Công thức xác định:

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
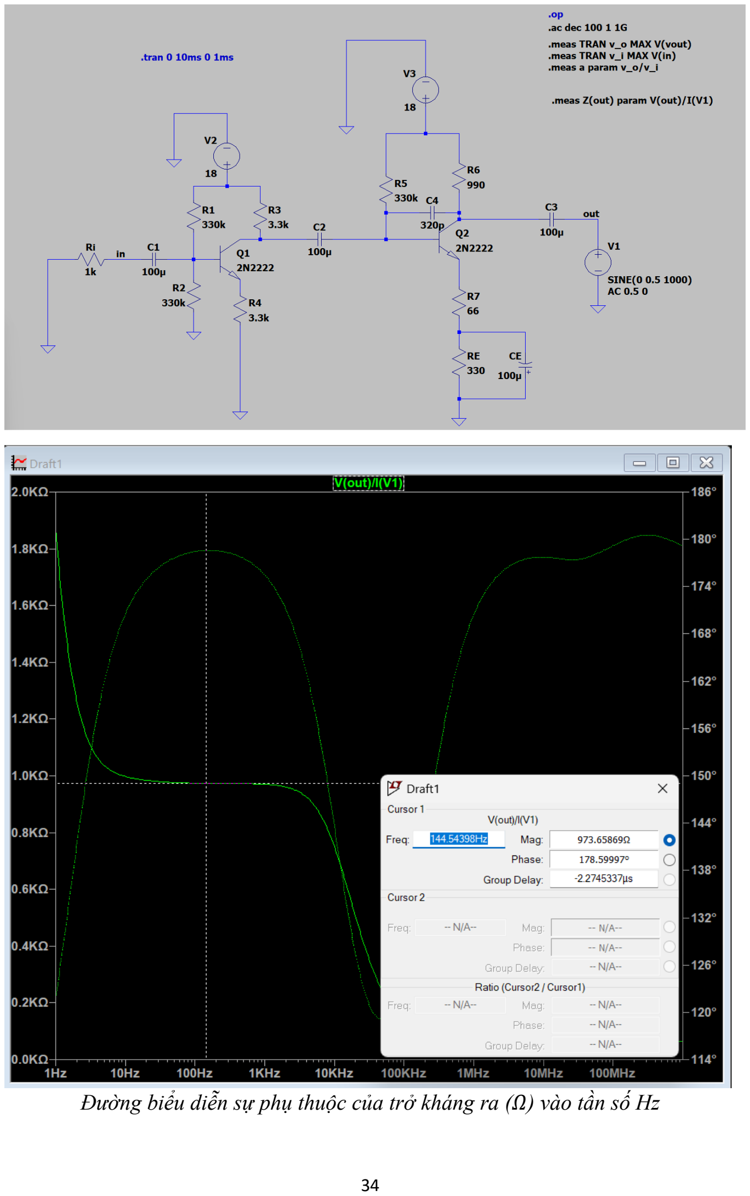
[picture p35: page 34]

Đường biểu diễn sự phụ thuộc của trở kháng ra (Ω) vào tần số Hz

- So sánh kết quả thu được:
Thông số | Yêu cầu | Tính toán | Mô phỏng
Trở kháng vào | > 100k | 132kΩ | 130kΩ
Trở kháng ra | < 1kΩ | 990Ω | 974Ω
Av | 10 | 10 | 9.98476
Băng thông | 15Hz – 15kHz | 15Hz – 15kHz | 22Hz – 13kHz

Theo như quan sát, ta thấy các thông số mô phỏng không sai khác quá nhiều so

với tính toán, các kết quả gần giống với yêu cầu đề ra ban đầu. Nguyên nhân sai số có

thể là do trong quá trình làm tròn khi tính toán, mô hình tương đương gần đúng tín hiệu

nhỏ, cách đo, hạn chế của phần mềm mô phỏng khó lấy chính xác các giá trị tần số cần

quan sát, chỉ có thể lấy gần đúng, tương đối.

- Kết luận

Ở phần mô phỏng trên PROTEUS và LT SPICE nhóm em đưa ra kết luận sau:

- Đáp ứng được độ lợi là AV = 10 (V/V) mô phỏng chính xác trên Proteus và LTSPICE
- Đáp ứng được yêu cầu trở kháng ngõ vào Rin > 100K Ω
- Đáp ứng được trở kháng ngõ ra Rout <1K Ω
- Mô phỏng được khuếch đại âm thanh (chèn nhạc vào Proteus)

IV. | MÔ PHỎNG THỰC TẾ
| Sơ đồ khối của mạch:

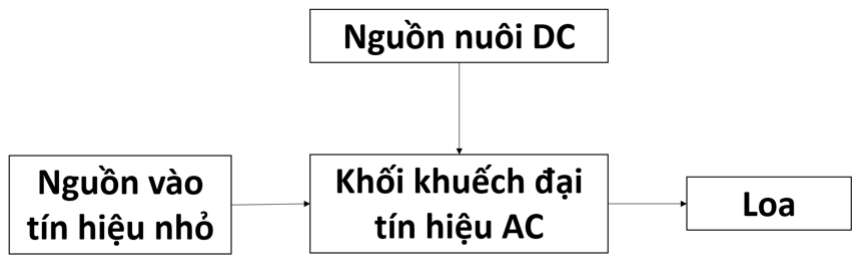
[picture p36: figure]

Cấu tạo mạch: 4 phần chính gồm Nguồn nuôi DC, Nguồn vào tín hiệu nhỏ

(Vppmax= 1V), Khối khuếch đại tín hiệu AC, và đầu ra được nối với loa.

Nguồn nuôi DC: sử dụng nguồn 18V, gồm hai pin 9V ghép nối tiếp; có thay thế thêm bằng nguồn Adapter 18V trong trường hợp 2 nguồn pin 9V không khả quan.

Nguồn vào tín hiệu nhỏ: Sử dụng máy dao phát sóng, phát sóng sin biên độ 1Vpp, tần số 1kHz.

Khối khuếch đại AC: nhóm em sử dụng transitor 2N2222A với độ khuếch đại đã tính toán trong phần 2 lý thuyết tính toán, kết nối thêm các linh kiện như trở, tụ điện để đảm bảo các yêu cầu của đề.

Kiểm tra: Dùng máy dao động ký 2 kênh, kênh 1 đo sóng ngõ vào, kênh 2 đo sóng ngõ ra

Vì không có các trở và tụ thực có giá trị tưởng ứng với mô phỏng nên các linh kiện được thay thế bằng các giá trị tương đương:

- Ri = 1 kΩ | - C1 = 100 μF
- R1 = 330 kΩ | - C2 = 100 μF
- R2 = 330 kΩ | - C3 = 0.33 μF
- R3 = 3.3 kΩ | - C4 = 320 pF
- R4 = 3.3 kΩ | - CE = 100 μF
- R5 = 330 kΩ
- R6 = 990 Ω
- R7 = 66 Ω
- RE = 330 Ω
- RL = 10 kΩ

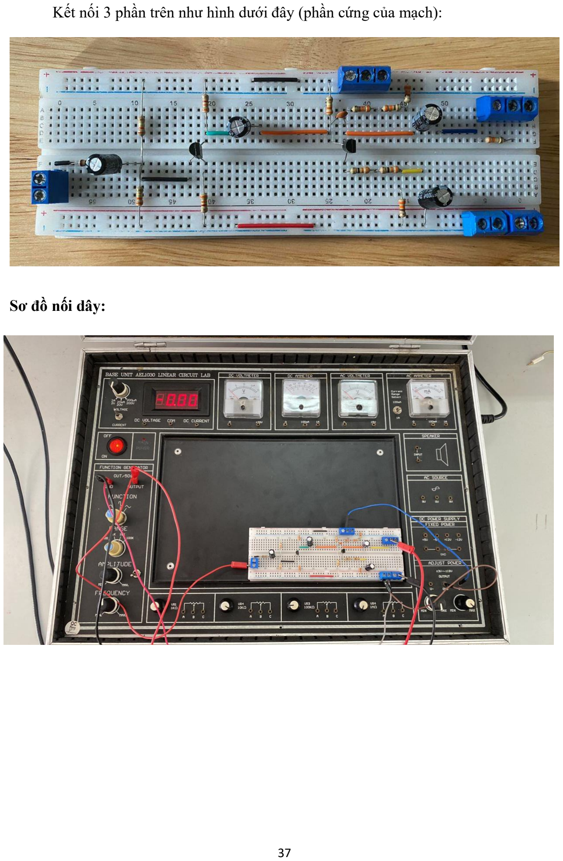
[picture p37: page 37]

Kết nối 3 phần trên như hình dưới đây (phần cứng của mạch):

Sơ đồ nối dây:

### 4.1. Đo độ lợi Av:

Với ngõ vào Vi biên độ 1V-pp, tần số 2 kHz, ta có kênh 1 (màu vàng) đo dạng

sóng ngõ vào và kênh 2 (màu xanh) đo dạng sóng ngõ ra:

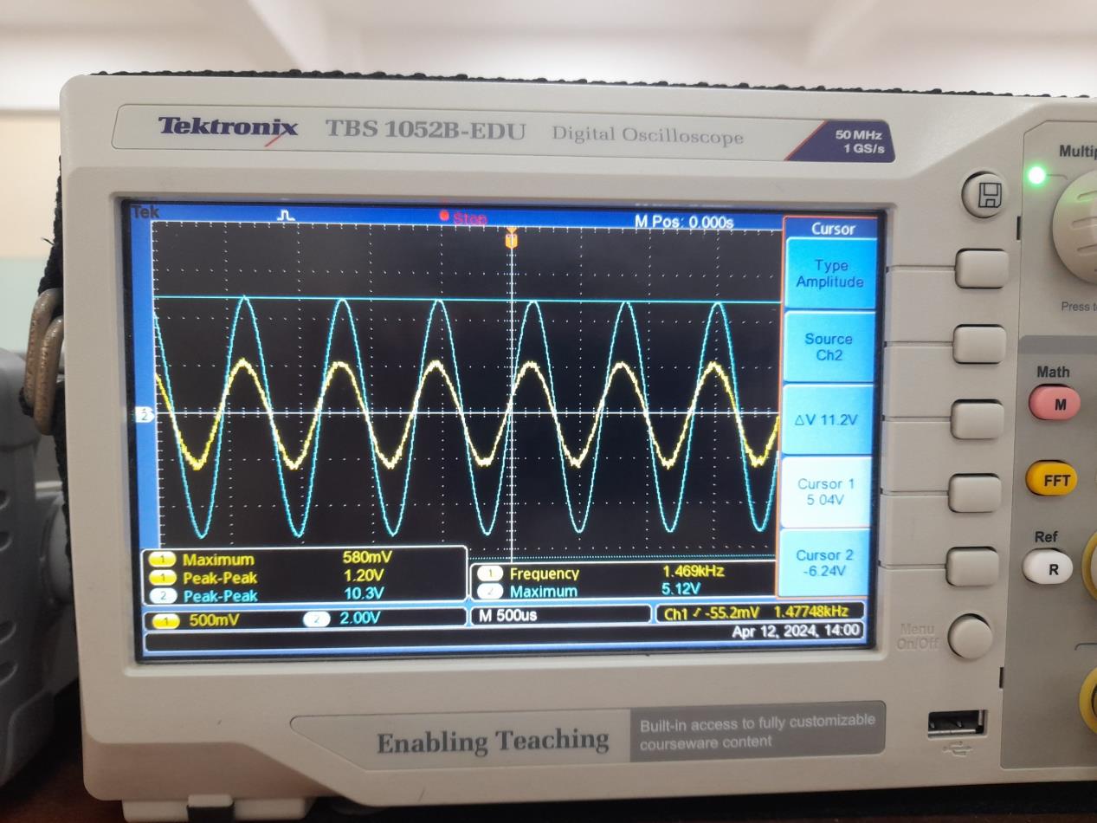
[picture p38: figure]

Ta có :

Av =

Vo−pp

Vi−pp

=

10.3
1.20 = 8.58 (

V
V

)

### 4.2. Khảo sát băng thông:

- Tần số cắt thấp:

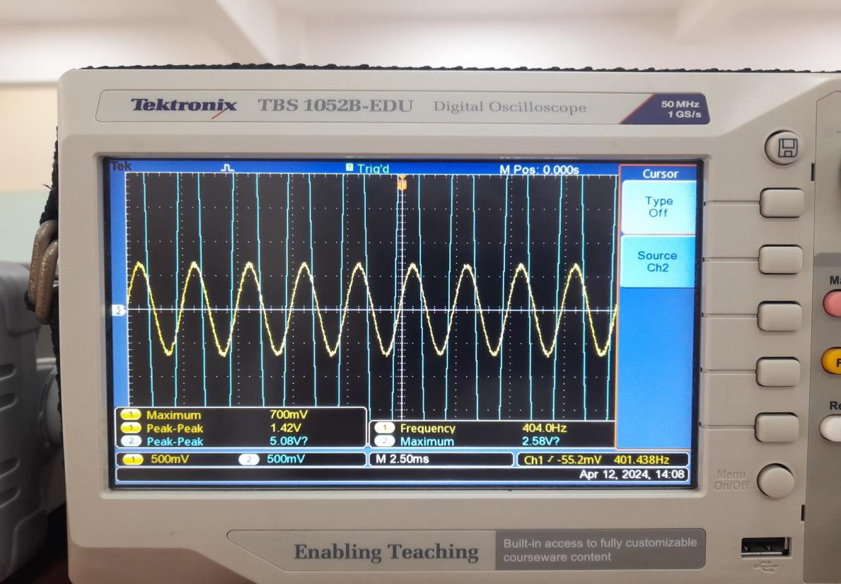
[picture p39: figure]
