hodat008/Amplifier-circuit/Simulation results.png

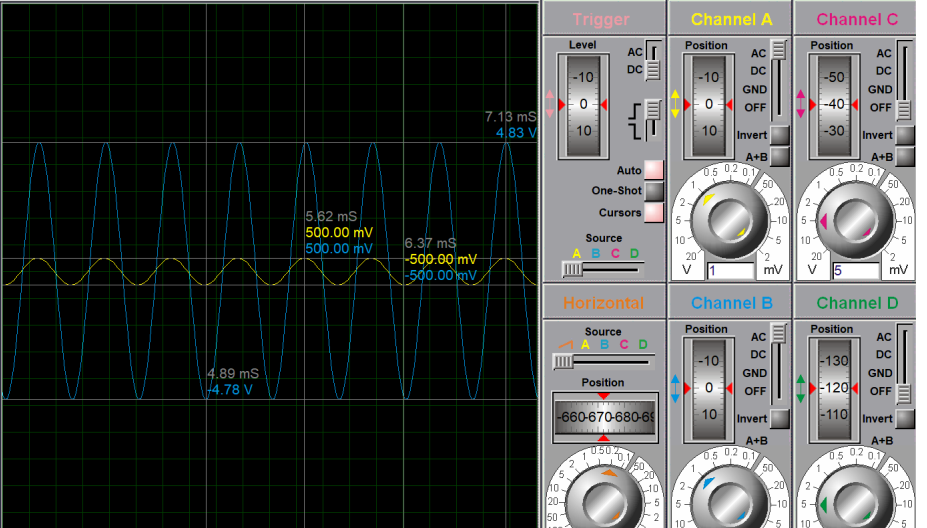
Simulation results.png
