hodat008/Amplifier-circuit/(list of files, drawings)

Other design files:
Amplifier circuit.pdsprj
